rarepotato8de/RoRo80/firmware/solder/roro80/v2_underglow/config.h

/*
Copyright

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
You should have received a copy of the GNU General Public License
along with this program.  If not, see <http://www.gnu.org/licenses/>.
*/
#pragma once

#include "config_common.h"

/* key matrix size */
#define MATRIX_ROWS 6
#define MATRIX_COLS 18

// ROWS: Top to bottom, COLS: Left to right
#define MATRIX_ROW_PINS {GP1, GP2, GP3, GP25, GP14, GP15}
#define MATRIX_COL_PINS {GP18, GP19, GP20, GP21, GP22, GP24, GP23, GP26, GP27, GP28, GP29, GP12, GP16, GP17, GP6, GP11, GP5, GP4}

/* COL2ROW or ROW2COL */
#define DIODE_DIRECTION COL2ROW

/* define if matrix has ghost */
//#define MATRIX_HAS_GHOST

/* Set 0 if debouncing isn't needed */
#define DEBOUNCE 5

#define QMK_ESC_OUTPUT C6 // usually COL
#define QMK_ESC_INPUT C4 // usually ROW

#define RGB_DI_PIN GP9
#define RGBLED_NUM 19
#define WS2812_PIO_USE_PIO1
#define RGBLIGHT_EFFECT_BREATHING
#define RGBLIGHT_EFFECT_RAINBOW_MOOD
#define RGBLIGHT_EFFECT_RAINBOW_SWIRL
#define RGBLIGHT_EFFECT_STATIC_GRADIENT
