rarepotato8de/RoRo80/(commit log)

2026-01-02 Update README.md
    solder info
2026-01-02 Update and rename RoRo80.kicad_sch to hardware/hotswap/RoRo80.kicad_sch
    [RoRo80.kicad_sch]
2026-01-02 solder hw
    [RoRo80.kicad_sch, bom.csv, designators.csv, positions.csv]
2026-01-02 UPDATE hs hardware
    [RoRo80.kicad_sch, bom.csv, designators.csv, positions.csv]
2026-01-02 fw for solder
